Engineering-Good/Push-Button/static/pushbutton.jpg

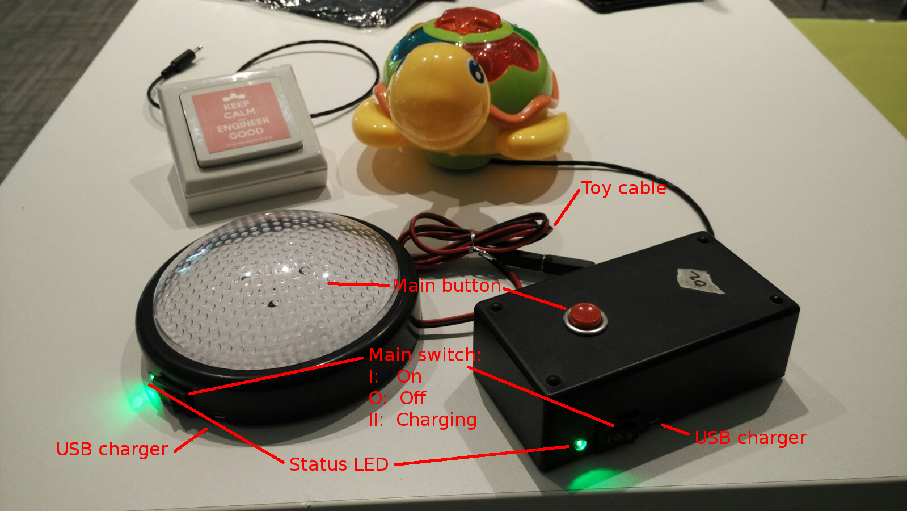
static/pushbutton.jpg
