Engineering-Good/Push-Button/README.md

# Push-Button
The aim of this project is to build a push button used for activating a toy. This push button will operate the toy for 3s after it is pressed, and deactivate after a random number of presses. The teacher then needs to reset the switch to restore it to normal operation.
