Engineering-Good/Push-Button/static/espdownloadtool.png

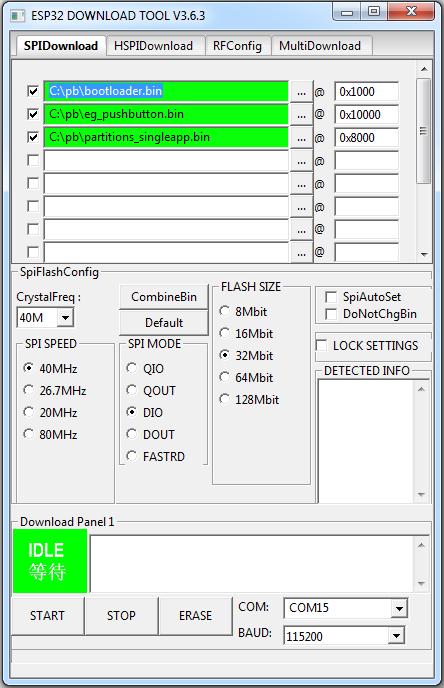
static/espdownloadtool.png
