Engineering-Good/Push-Button/static/schematics.png

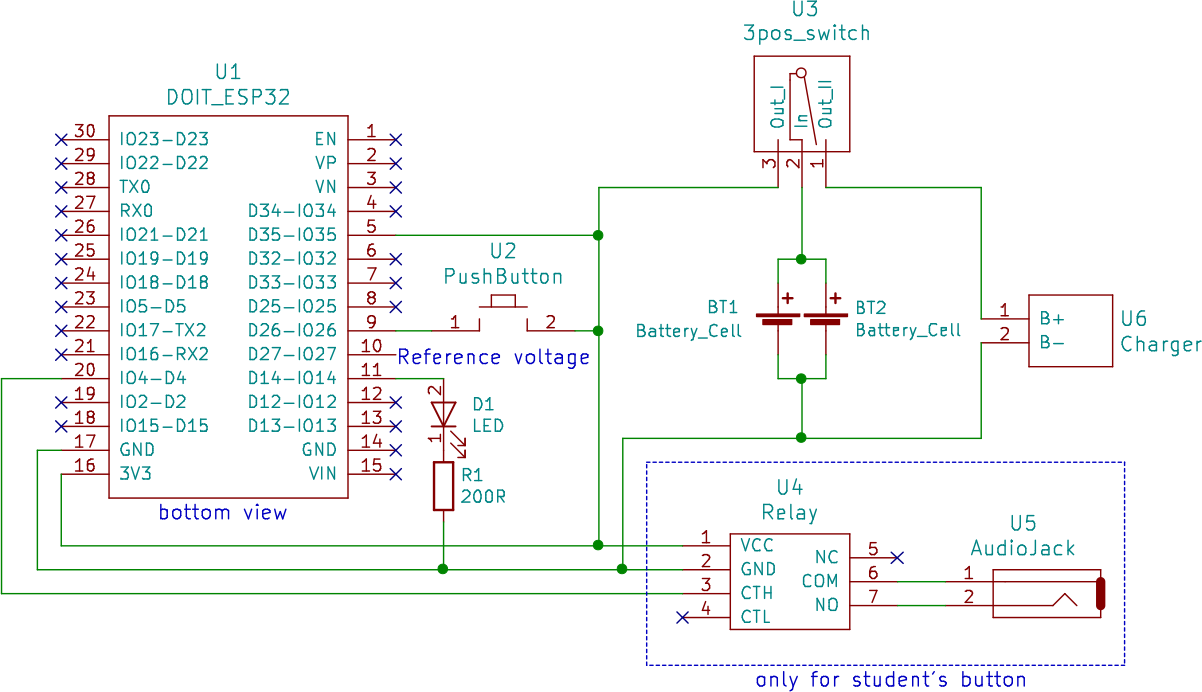
static/schematics.png
