Engineering-Good/Push-Button/V2-Remote Reset Switch/BOM.xlsx

Pushbutton
Item | DE price (€) | DE link | Global price (US$) | Global link | Heiko to bring | Heiko to send | Hannah to buy
Pushbutton + battery holder (2*AA) |  |  |  |  |  |  | 10
LiFePo AA battery |  | http://www.ebay.de/itm/2x-GM-E-LiFePo4-3-2V-IFR-14500-AA-600mAh-Akku-Zelle-/192269766203 | 2.85 | http://www.dx.com/p/coolook-aa-3-2v-700mah-rechargeable-lifepo-battery-black-white-2-pcs-214563 |  | 20
Battery switch |  |  |  |  |  |  | 10
Charger board | 2.75 | http://www.ebay.de/itm/Micro-USB-5V-TP5000-3-6V-1A-Charger-Module-3-2V-LiFePO4-Battery-Charging-Board-/272756748781 |  | http://www.ebay.com/itm/DC-5V-Micro-USB-3-6v-Charger-Module-1S-3-2V-LiFePO4-Battery-Cell-Charging-Board-/192222724417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 | 1 | 9
Microcontroller ESP32 |  |  | 6.99 | https://www.banggood.com/ESP32-DevKit-ESP32-WiFiBluetooth-Development-Board-ESP-WROOM-32-Dual-Cores-Board-p-1138249.html |  | 10
3V relay module | 2.25 | https://www.amazon.de/MagiDeal-Kanal-Relais-Arduino-Module/dp/B06ZY6Y9ST/ | 2.03 | http://www.ebay.com/itm/3V-10A-1-Channel-Relay-Board-Module-Optocoupler-LED-for-Arduino-PIC-ARM-AVR-/201993006934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 | 1 | 4
Audio socket |  |  |  |  |  |  | 1
