Engineering-Good/Push-Button/V1_Hardwired Reset Switch/3D Print Files/Bottom Cover.STL

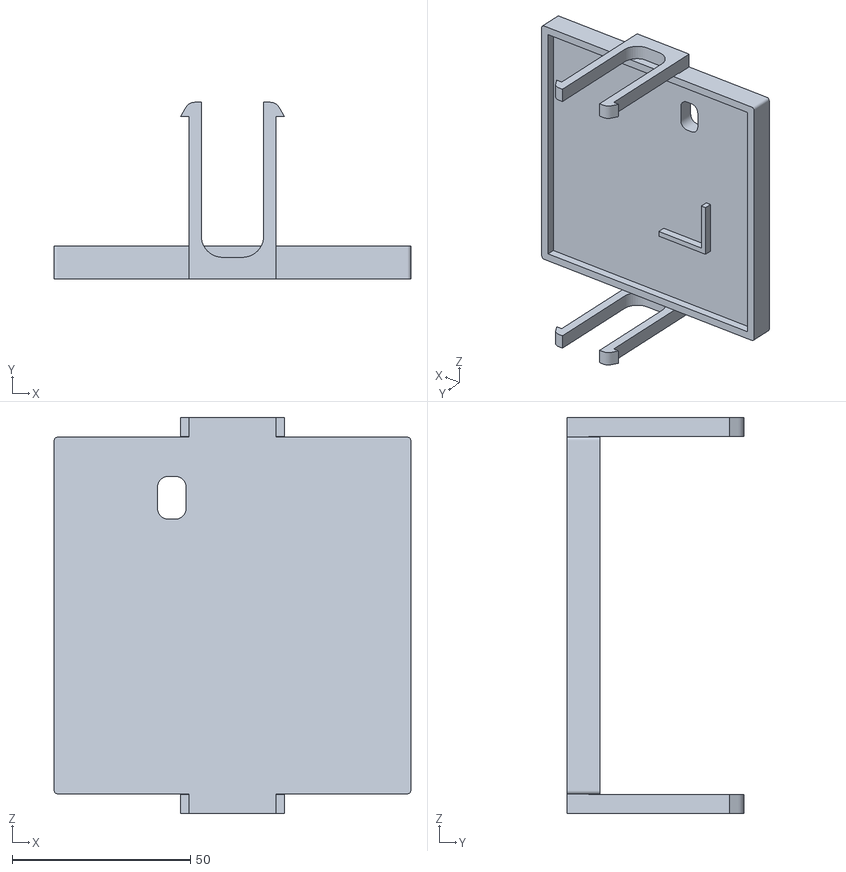
[picture p4: CAD file, 2023-02-07]
V1_Hardwired Reset Switch/3D Print Files/Bottom Cover.STL
100.0 x 49.5 x 111.0
