Engineering-Good/Push-Button/V1_Hardwired Reset Switch/3D Print Files/Electronic Housing.STL

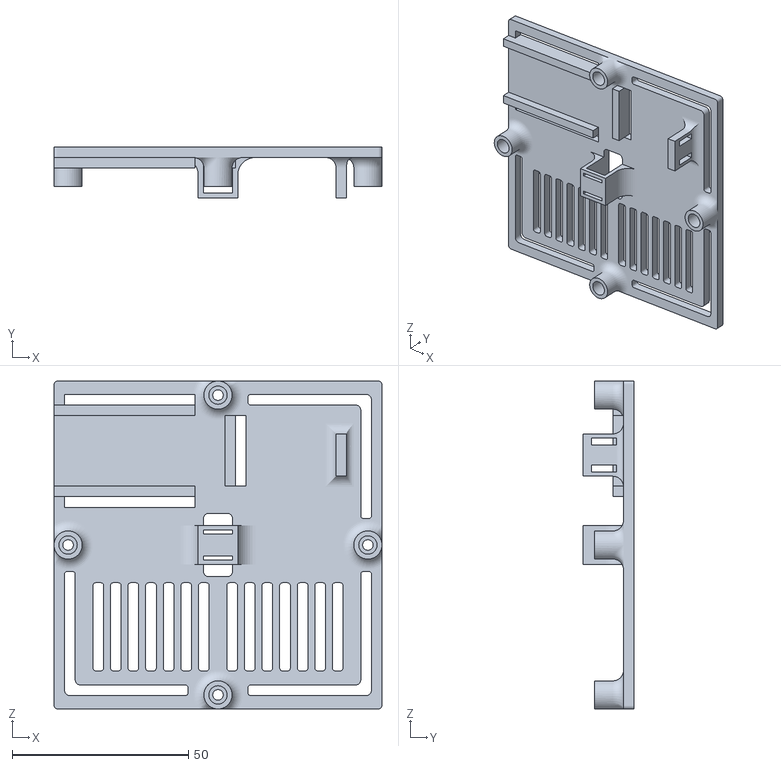
[picture p5: CAD file, 2023-02-07]
V1_Hardwired Reset Switch/3D Print Files/Electronic Housing.STL
93.0 x 14.5 x 93.0
