Engineering-Good/Push-Button/V1_Hardwired Reset Switch/3D Print Files/Top Cover.STL

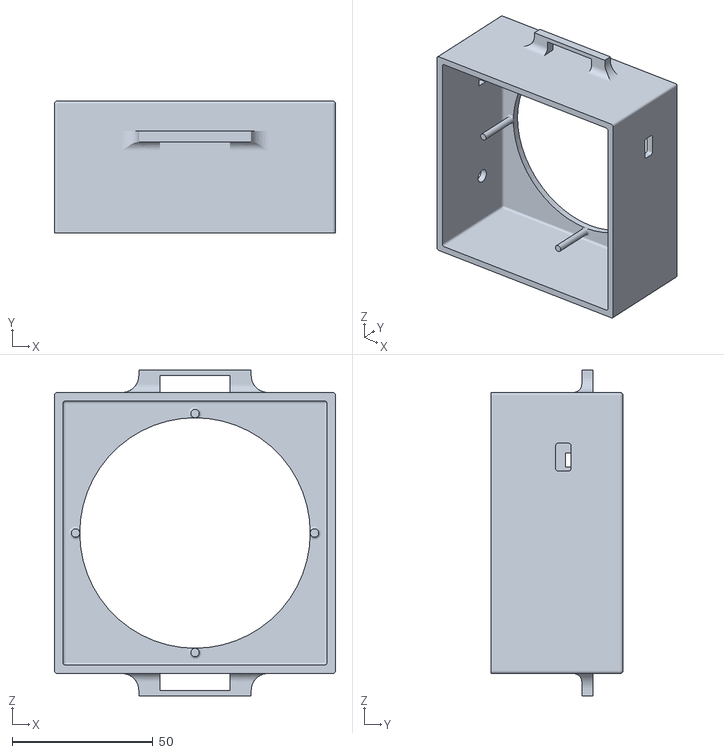
[picture p6: CAD file, 2023-02-07]
V1_Hardwired Reset Switch/3D Print Files/Top Cover.STL
100.0 x 47.0 x 116.0
