Engineering-Good/Push-Button/V1_Hardwired Reset Switch/3D Print Files/Press Plate.STL

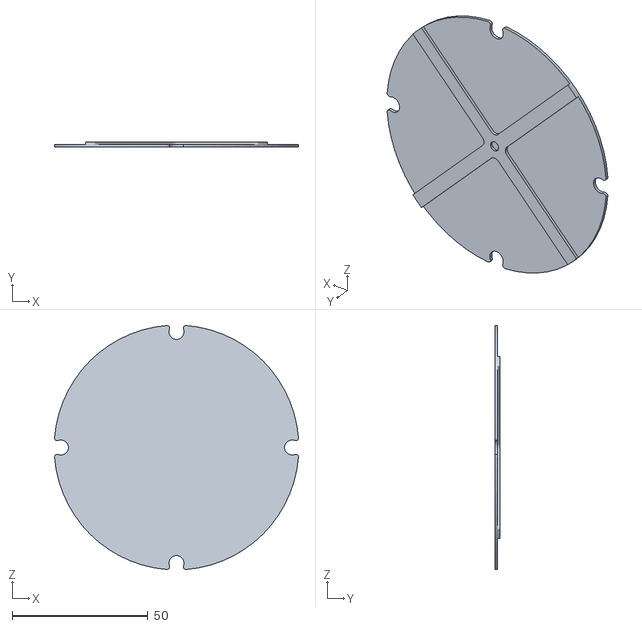
[picture p7: CAD file, 2023-02-07]
V1_Hardwired Reset Switch/3D Print Files/Press Plate.STL
89.7 x 2.00 x 89.7
